Squibs/DualSense-Padhack/images/2.jpg

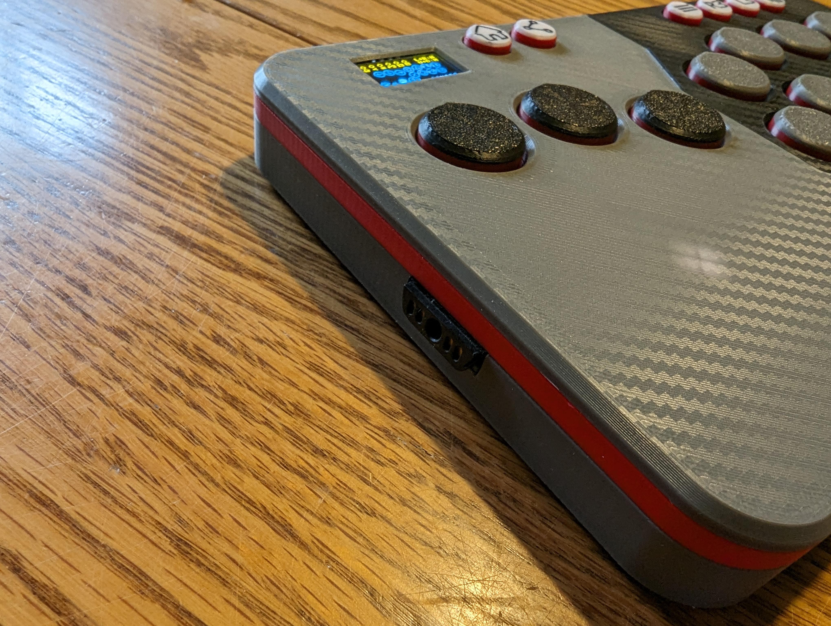
images/2.jpg
