Squibs/DualSense-Padhack/images/3.jpg

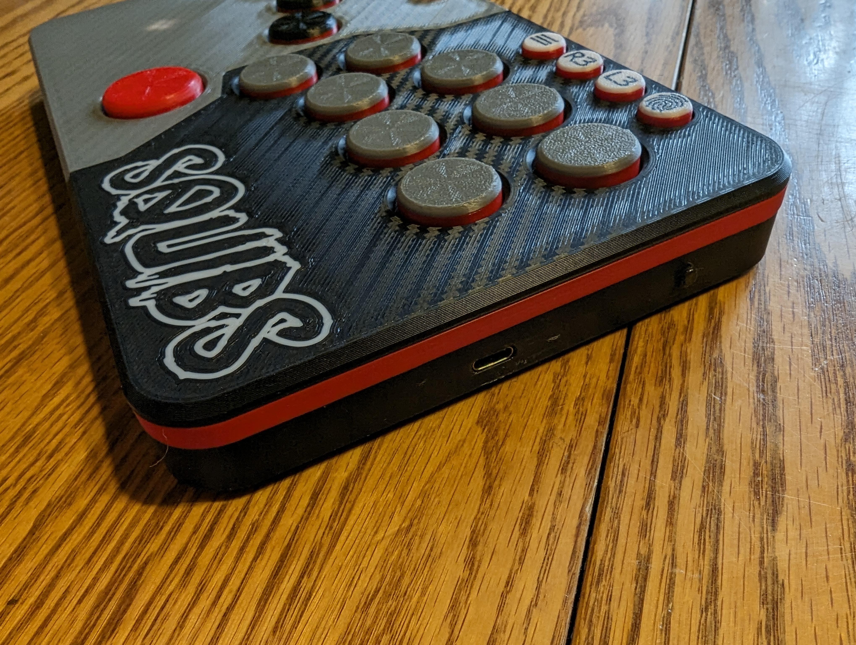
images/3.jpg
