Squibs/DualSense-Padhack/images/4.jpg

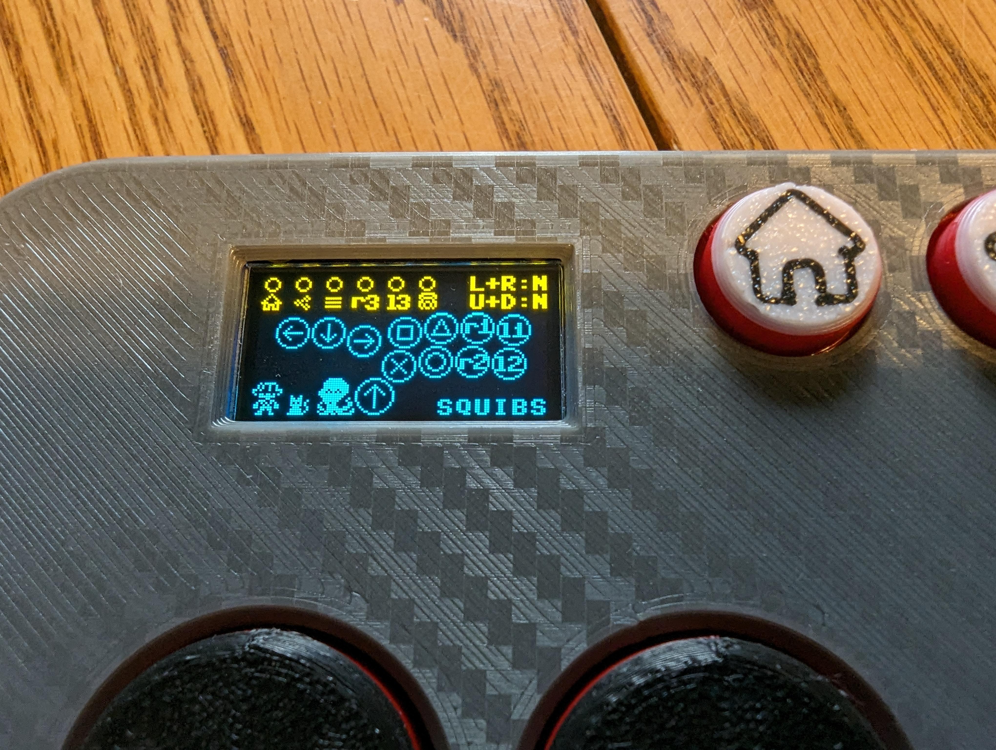
images/4.jpg
