Squibs/DualSense-Padhack/images/5.jpg

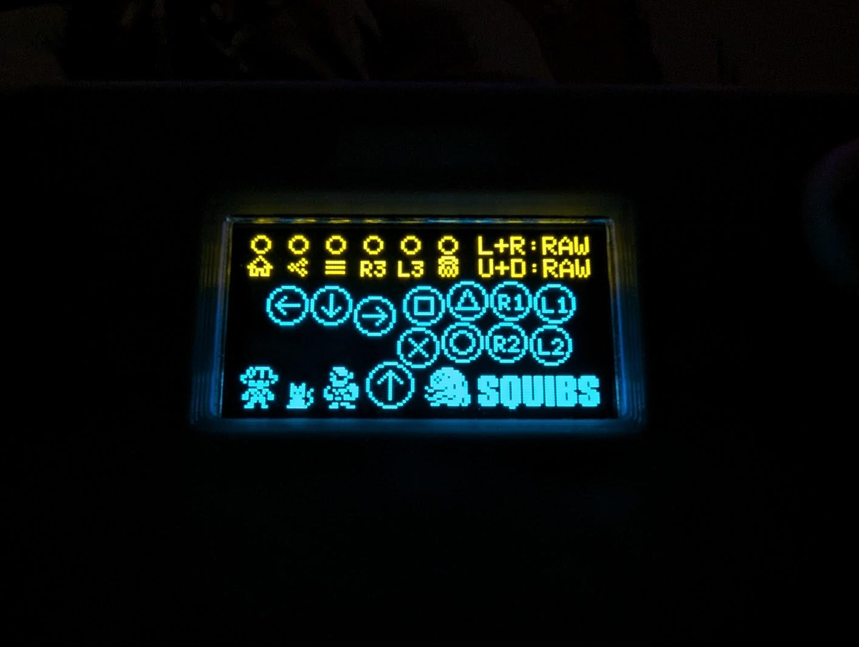
images/5.jpg
