Squibs/DualSense-Padhack/images/6.jpg

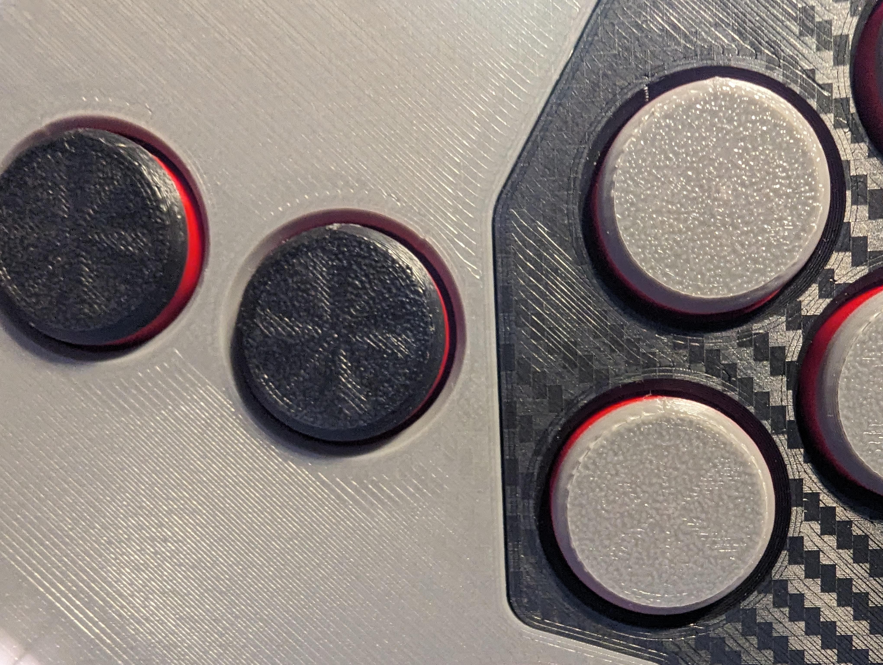
images/6.jpg
