Squibs/DualSense-Padhack/images/7.jpg

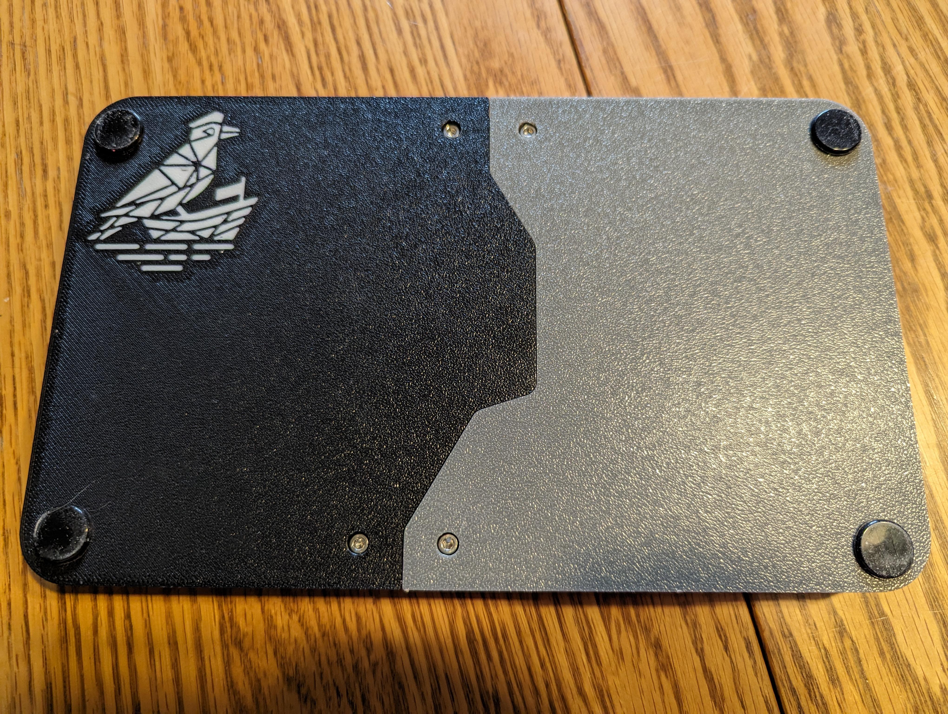
images/7.jpg
