Squibs/DualSense-Padhack/images/8.jpg

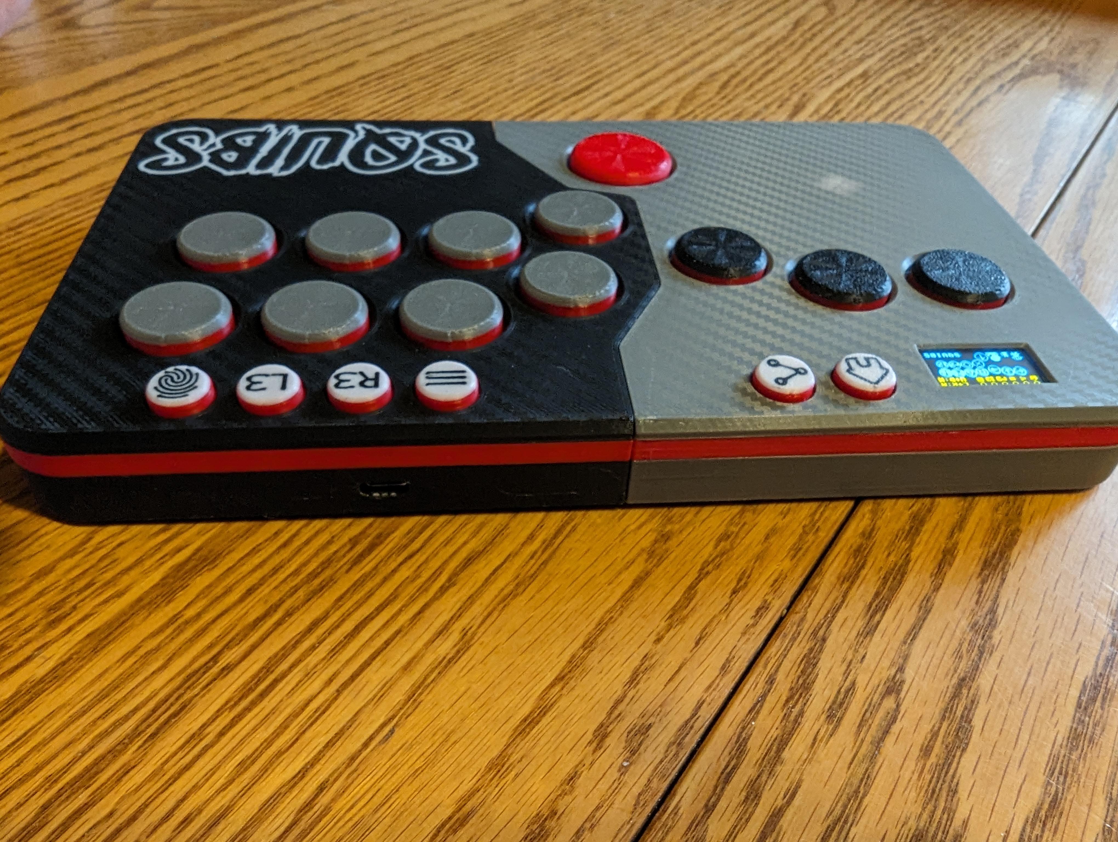
images/8.jpg
