Squibs/DualSense-Padhack/images/9.jpg

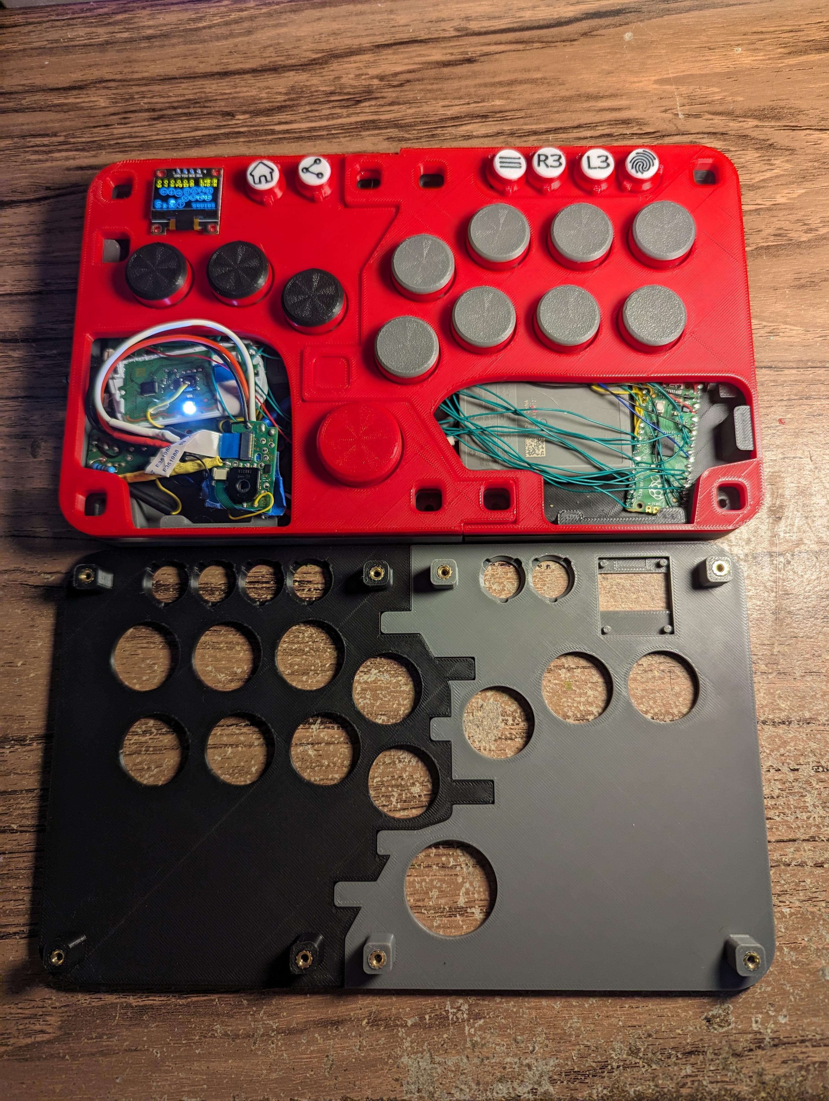
images/9.jpg
