Squibs/DualSense-Padhack/(commit log)

2024-04-01 Wiring guide
2024-04-01 Update and rename Wiring Guide.png to wiring-guide.png
2024-04-01 fix wiring-guide image
2024-04-03 Fixed reversed SOCD speech text.
    [useSOCD2.cpp]
2026-04-30 Added battery meter
2026-05-05 Switched to reading battery with adc pin directly from dualsense battery
2026-08-12 Added power off timer for home button
2026-08-12 100ms more on power off timer
